damilareadekeye/Gesture-Controlled-Smart-Home-System-with-NRF24L01-Wireless-Communication/circuit-diagrams/Circuit Diagram BW.pdf

## LCD2

V2

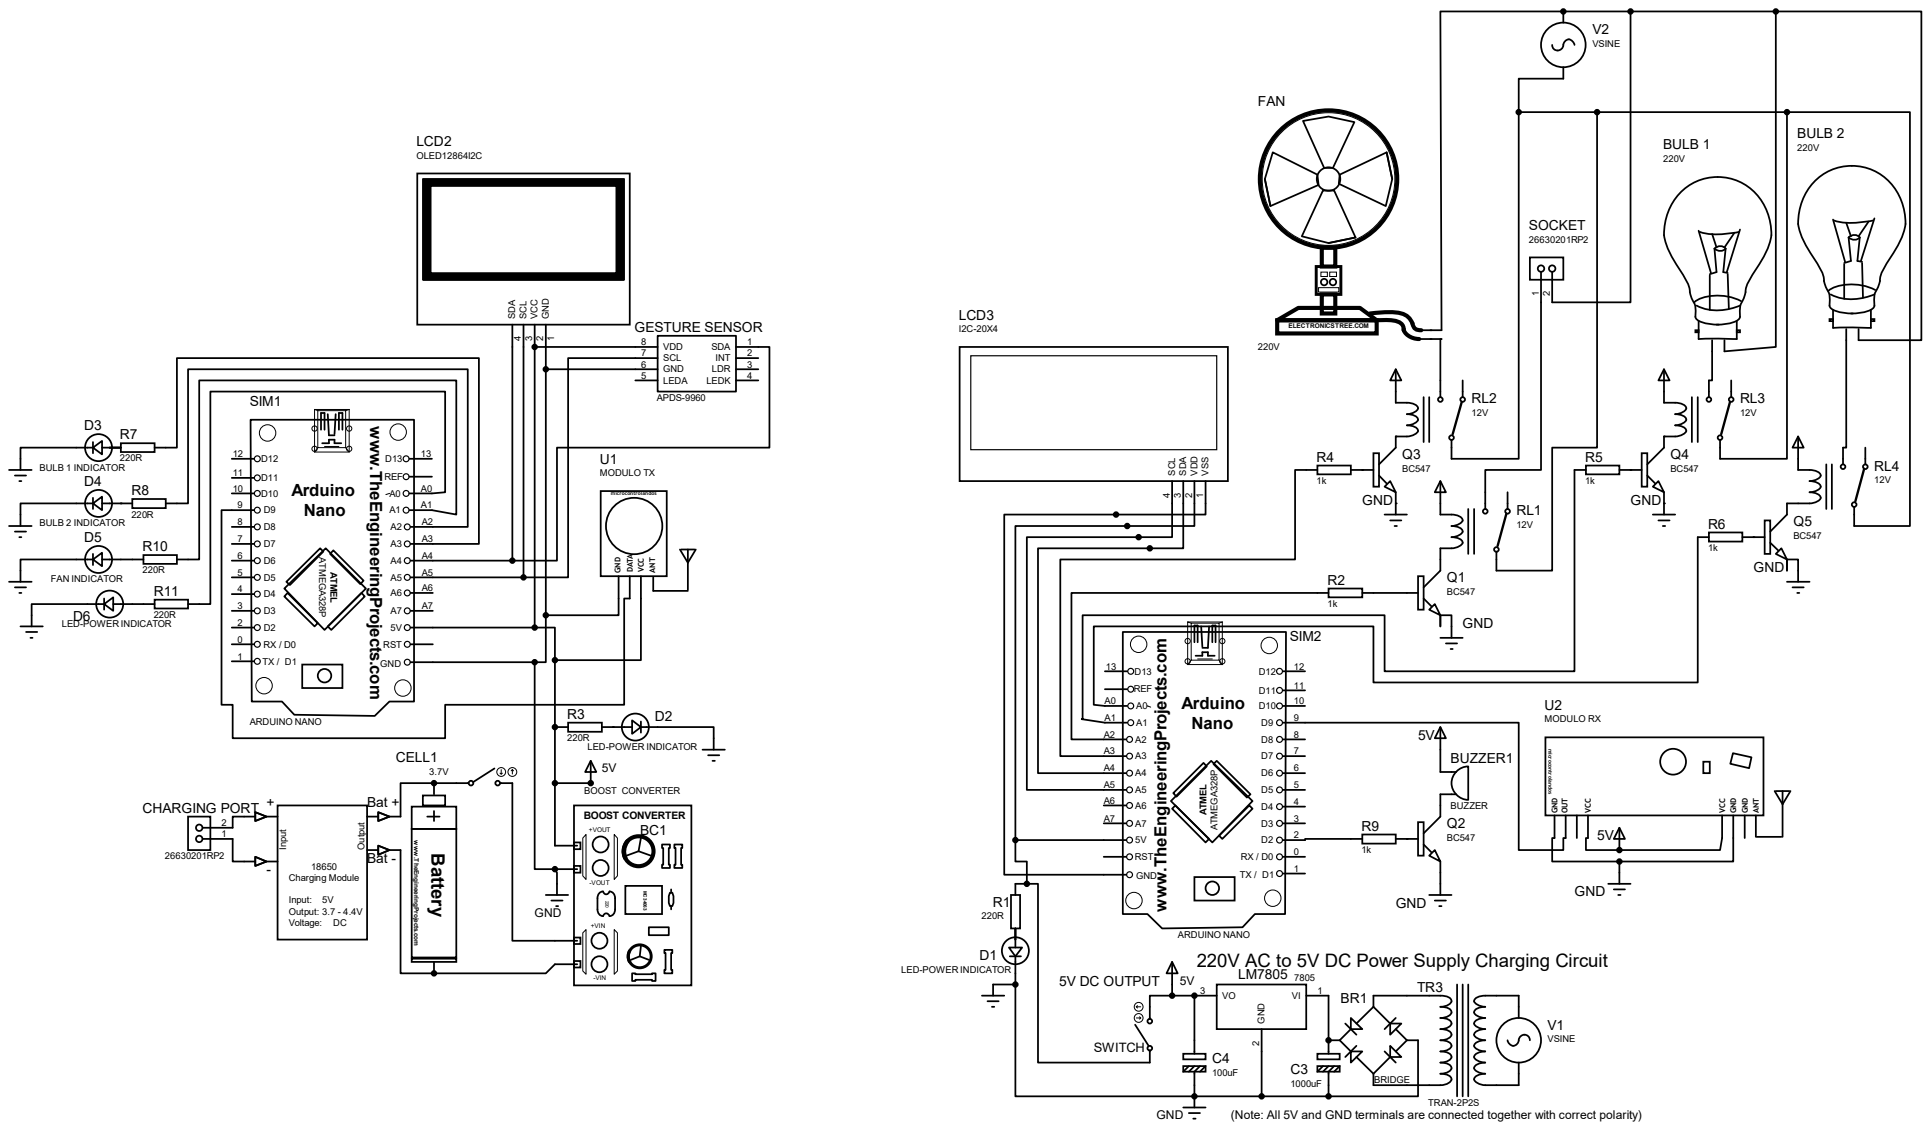
[picture p1: page 1]

microcontrolandos GND DATA VCC ANT

MODULO RX Battery www.TheEngineeringProjects.com

ARDUINO NANO
220V AC to 5V DC Power Supply Charging Circuit
