damilareadekeye/Gesture-Controlled-Smart-Home-System-with-NRF24L01-Wireless-Communication/reference-sketches/nrf24l01-tx-rx-text-test/Receiver/Receiver.ino

// Code 1 : Sending Text (Receiver)
// Library: TMRh20/RF24 (https://github.com/tmrh20/RF24/)

#include <SPI.h>
#include <RF24.h>
#include <nRF24L01.h>

RF24 radio(9, 10); // CE, CSN
const byte address[10] = "ADDRESS01";

void setup() {
  Serial.begin(115200);
  radio.begin();
  radio.openReadingPipe(0, address);
  radio.setPALevel(RF24_PA_MIN);
  radio.startListening();
};

void loop() {
  if (radio.available()) {
    char txt[32] = "";
    radio.read(&txt, sizeof(txt));
    Serial.println(txt);
  };
};
