damilareadekeye/Gesture-Controlled-Smart-Home-System-with-NRF24L01-Wireless-Communication/(commit log)

2026-05-22 Expand README with wiring tables, features, serial reference, troubleshooting and operation flow
2026-05-29 Add Proteus circuit diagrams (colour and BW PDF)
    - circuit-diagrams/Circuit Diagram Colour.pdf
    - circuit-diagrams/Circuit Diagram BW.pdf
